aj-floater/hexapod/media/callibration_rig1_5.jpeg

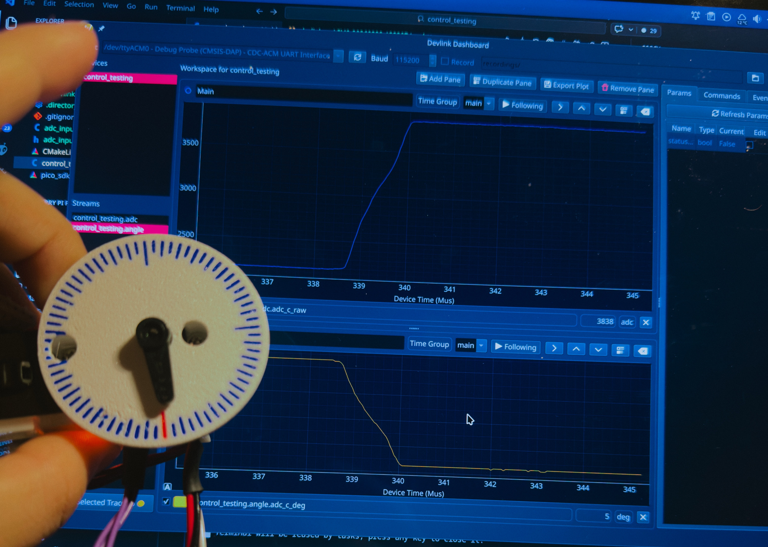
media/callibration_rig1_5.jpeg
