aj-floater/hexapod/media/callibration_rig1_86.jpeg

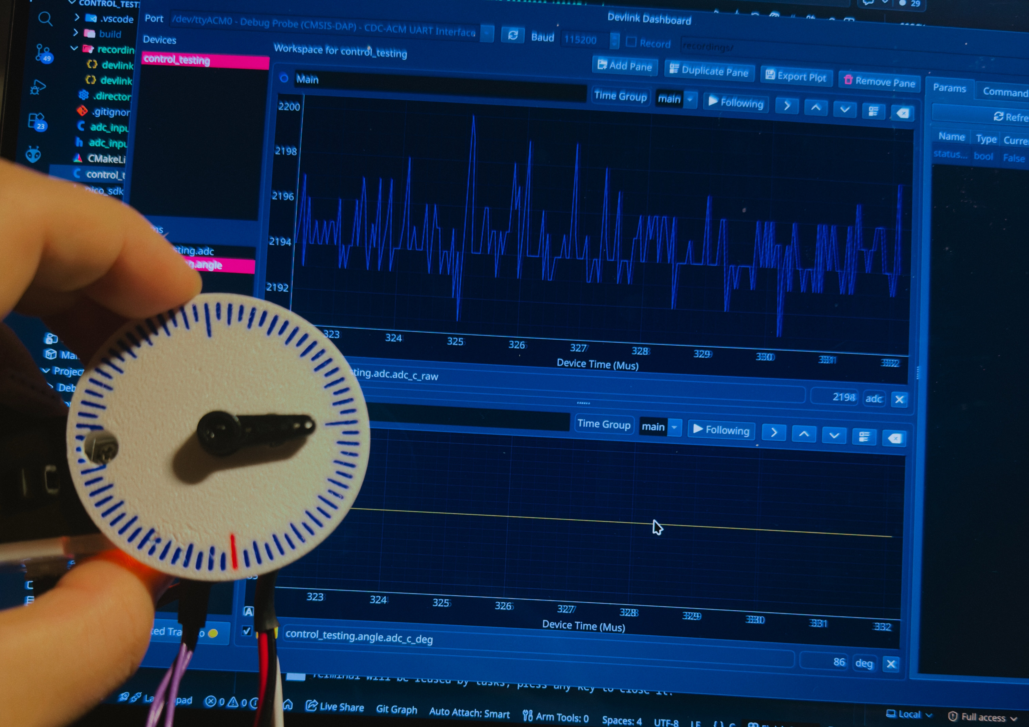
media/callibration_rig1_86.jpeg
