aj-floater/hexapod/hardware/smart_servo_v2/smart_servo_v2_log_missing3Dmodels.txt

[('Y1', '/Users/archiejames/coding/hexapod/hardware/smart_servo_v2/ABM8-272-T3.stp'), ('L1', '/Applications/KiCad/KiCad.app/Contents/SharedSupport/3dmodels/Inductor_SMD.3dshapes/L_Bourns_SRP7028A_7.3x6.6mm.step'), ('IC2', '/Users/archiejames/coding/hexapod/hardware/smart_servo_v2/MP2315GJ-P.stp'), ('IC1', '/Users/archiejames/coding/hexapod/hardware/smart_servo_v2/AP7370-33SA-7.stp')]
