aj-floater/hexapod/firmware/basic_control_testing/speed2_designed_servo_tracking_relative.png

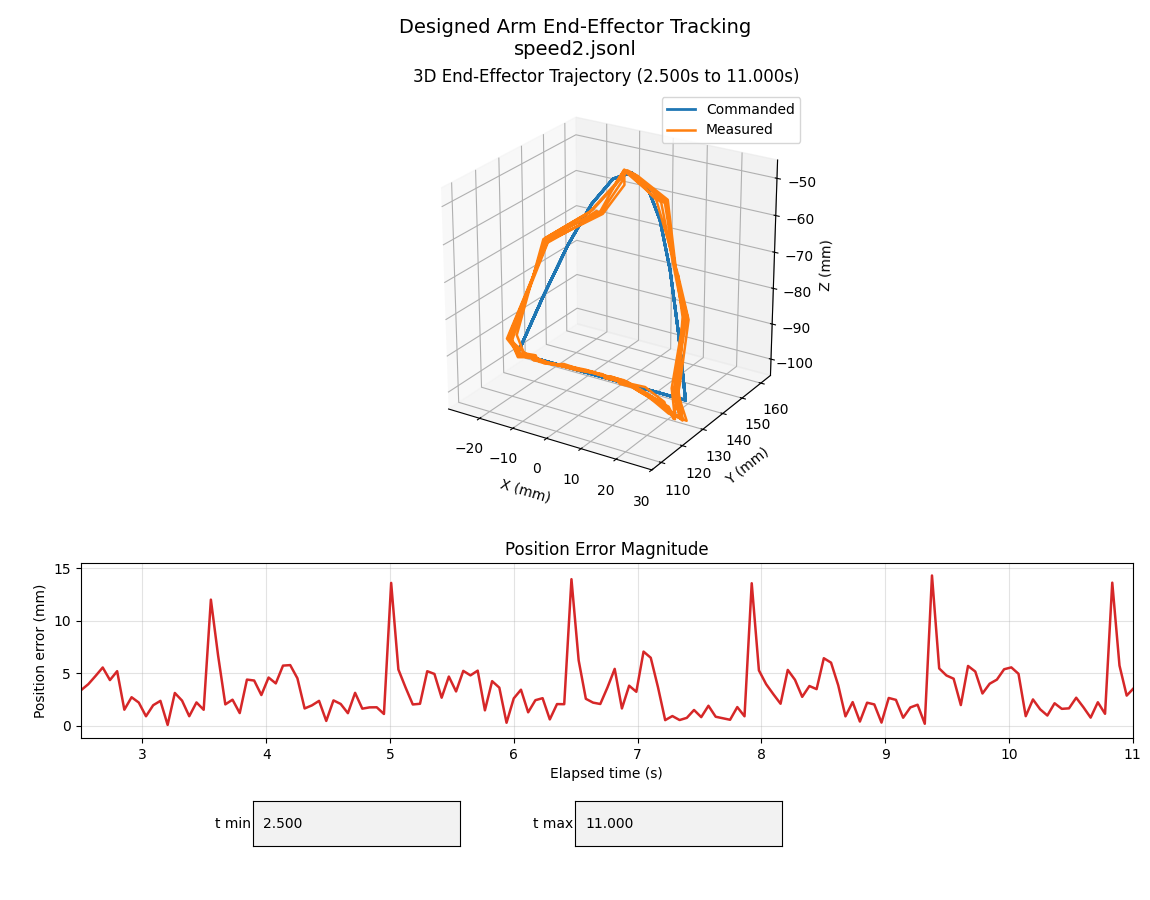
firmware/basic_control_testing/speed2_designed_servo_tracking_relative.png
