aj-floater/hexapod/media/Average & Low Pass Filtering.png

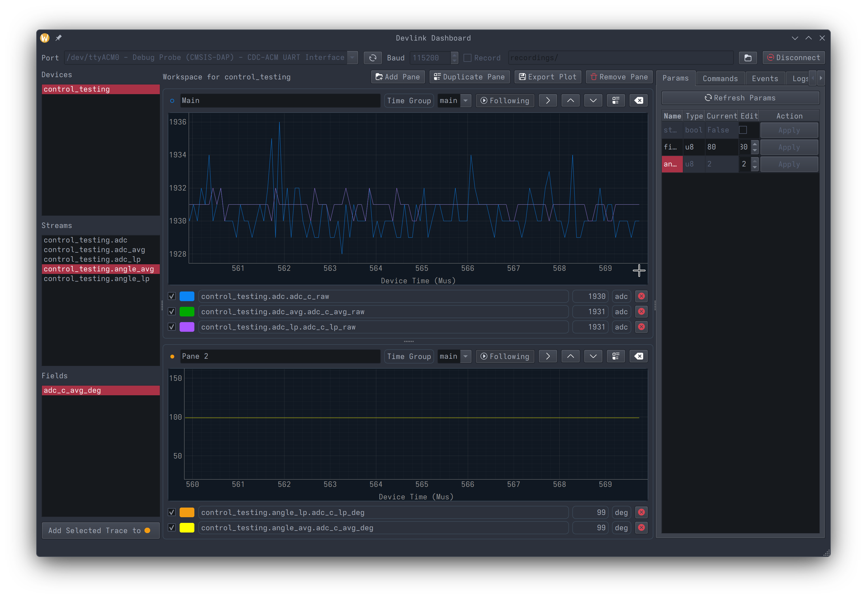
media/Average & Low Pass Filtering.png
