aj-floater/hexapod/media/bouncing.png

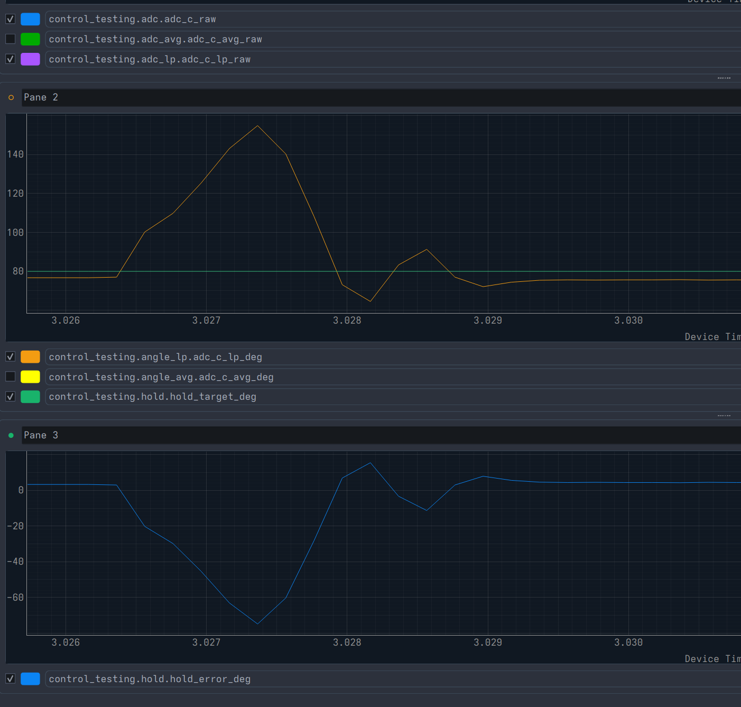
media/bouncing.png
