aj-floater/hexapod/media/callibration_rig1_87.jpeg

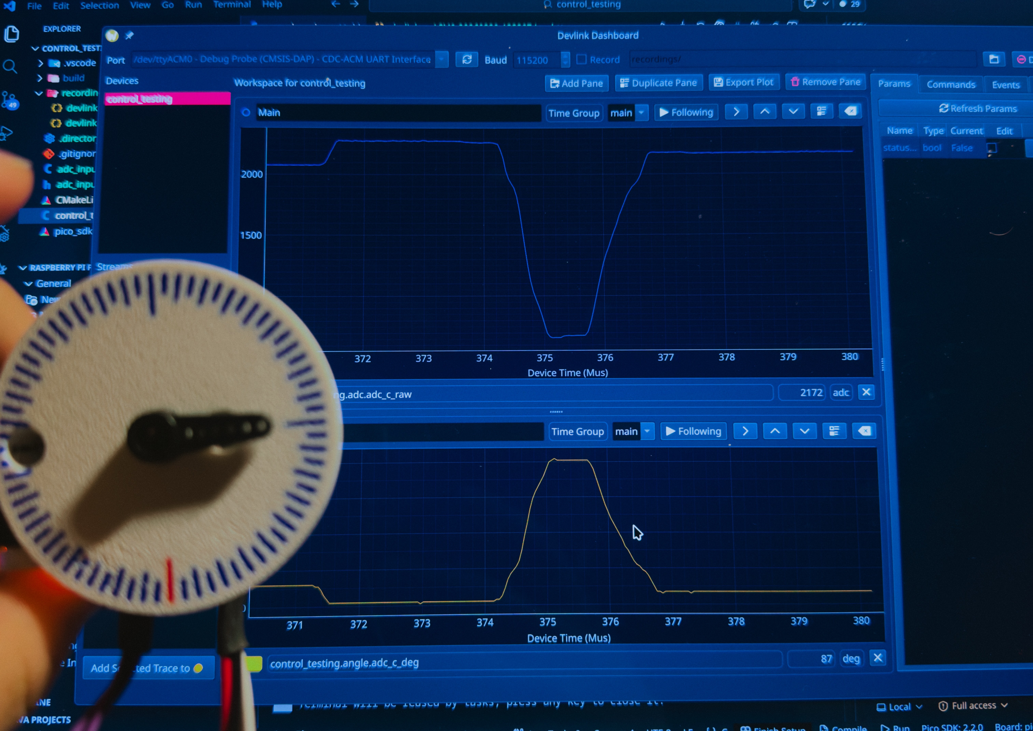
media/callibration_rig1_87.jpeg
