aj-floater/hexapod/media/callibration_rig1_180.jpeg

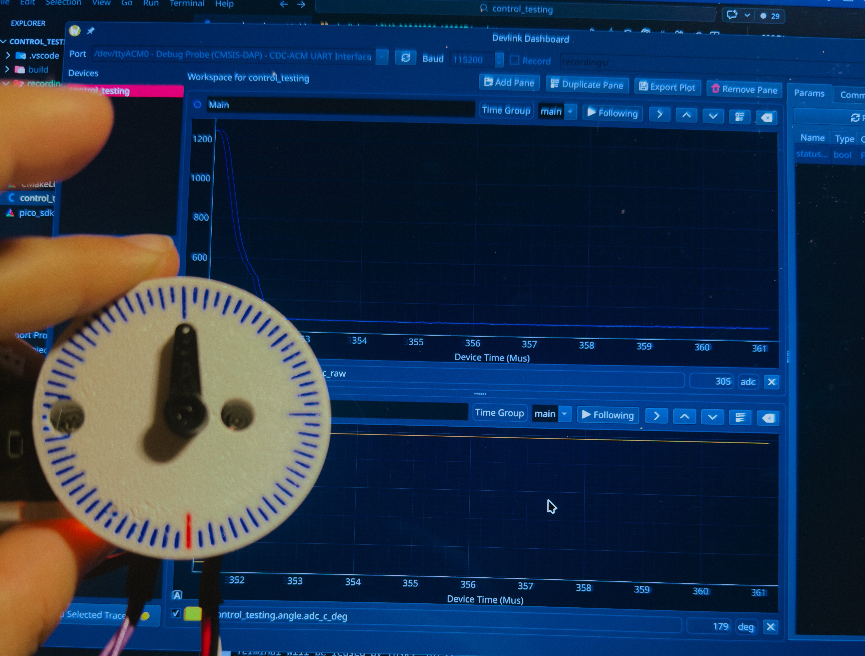
media/callibration_rig1_180.jpeg
