aj-floater/hexapod/media/callibration_rig.png

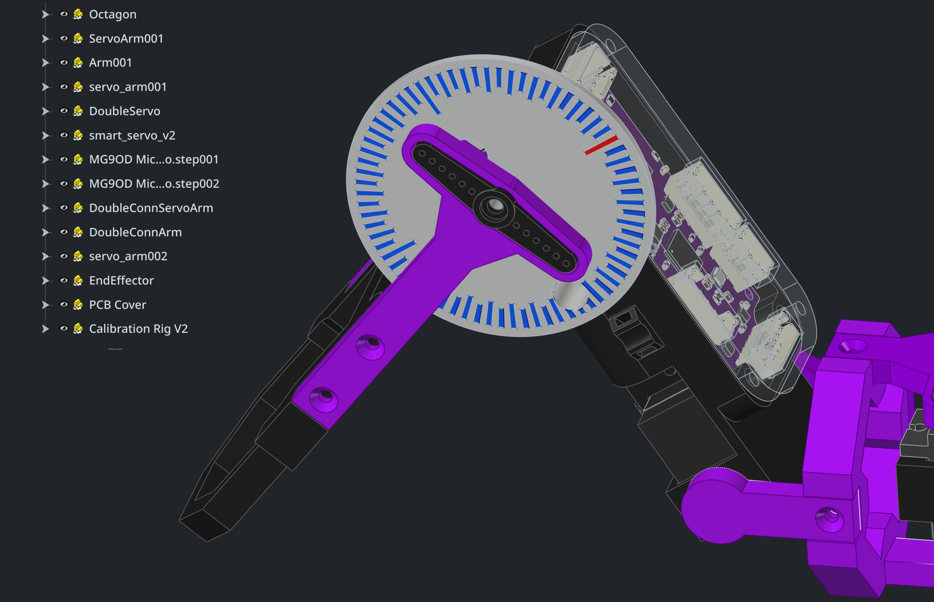
media/callibration_rig.png
