aj-floater/hexapod/media/first_callibration_rig.png

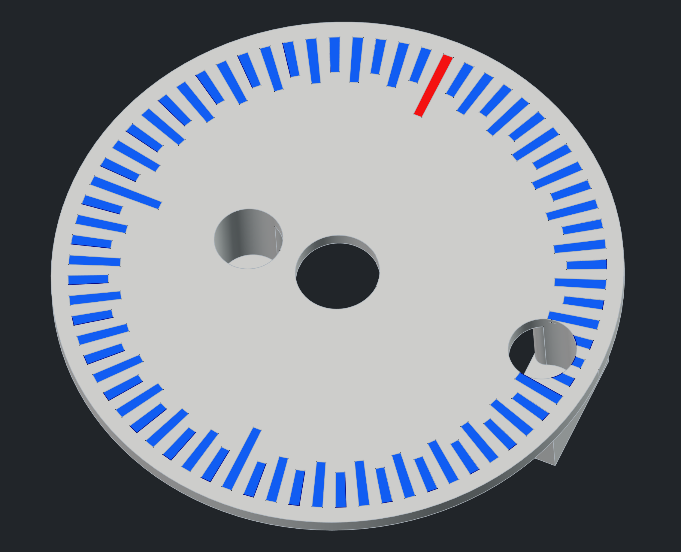
media/first_callibration_rig.png
