aj-floater/hexapod/media/NewCallibrationRig.png

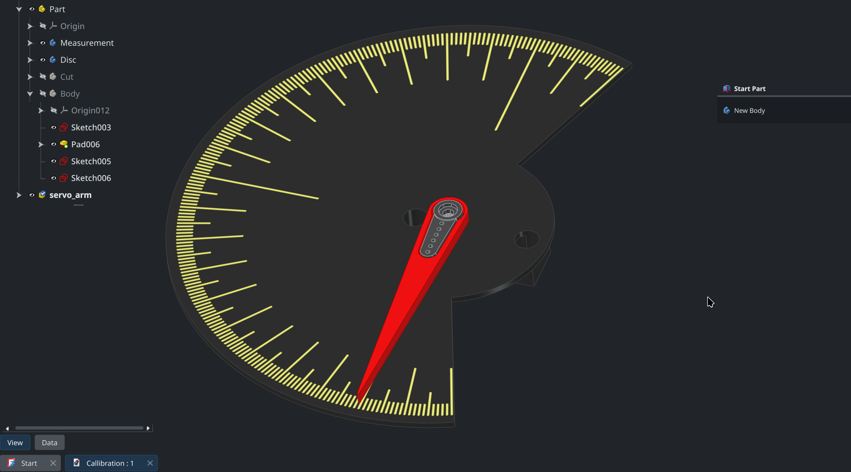
media/NewCallibrationRig.png
