aj-floater/hexapod/media/proportional_control.png

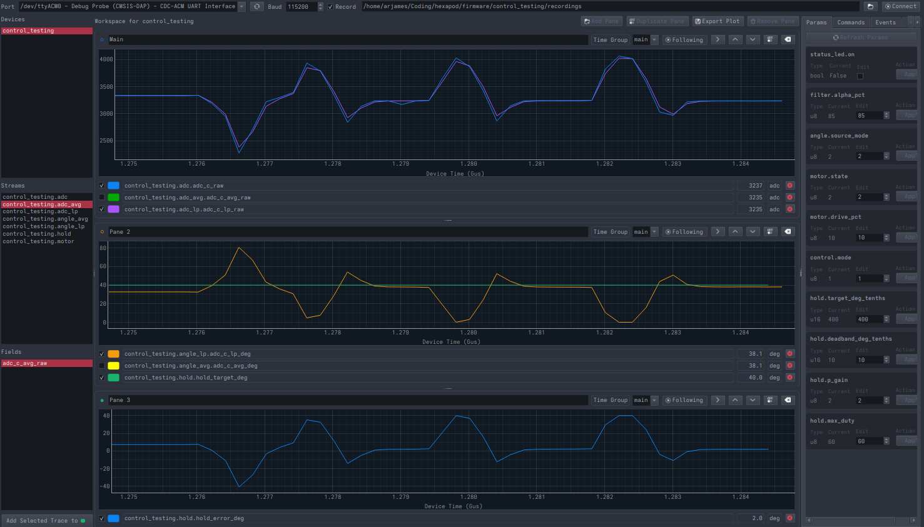
media/proportional_control.png
