aj-floater/hexapod/hardware/smart_servo/bom.xlsx

Quantity | Cost Per | Cost Total | Matched Part Number | Description | Selected Distributor | SKU | Distributor Link | Checked | Ordered
1 | £0.55 | £0.55 | MCP1703T-3302E/CB | Fixed LDO Voltage Regulator, 2.7V to 16V, 525mV Dropout, 3.3Vout, 250mAout, SOT-23A-3 | Farnell | 1439518 | https://uk.farnell.com/microchip/mcp1703t-3302e-cb/v-reg-ldo-250ma-3-3v-sot-23a-3/dp/1439518 | ✓
1 | £0.25 | £0.25 | TL431IDBZR,215 | Voltage Reference, Precision, Shunt - Adjustable, AEC-Q100 TL431 Series, 2.495V to 36V, SOT-23-3 | Farnell | 2095480 | https://uk.farnell.com/nexperia/tl431idbzr-215/voltage-ref-shunt-2-495v-36v-sot/dp/2095480 | ✓
1 | £2.21 | £2.21 | STM32F042F6P6 | ARM MCU, USB Line, STM32 Family STM32F0 Series Microcontrollers, ARM Cortex-M0, 32 bit, 48 MHz | Farnell | 2469549 | https://uk.farnell.com/stmicroelectronics/stm32f042f6p6/mcu-32bit-cortex-m0-48mhz-tssop/dp/2469549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 | ✓
1 | £0.92 | £0.92 | DRV8837DSGR | Motor Driver, Low Voltage H Bridge, 2 Outputs, 1.8 V to 7 V Supply, 0 V to 11 V/1.8 A Out, WSON-8 | Farnell | 3005855 | https://uk.farnell.com/texas-instruments/drv8837dsgr/motor-driver-dc-brushed-1-8a-wson/dp/3005855 | ✓
1 | £0.73 | £0.73 | 217179-0001 | USB Connector, USB Type C, USB 2.0, Receptacle, 16 Ways, Surface Mount, Through Hole Mount | Farnell | 3702965 | https://uk.farnell.com/molex/217179-0001/usb-conn-2-0-type-c-rcpt-16pos/dp/3702965?CMP=GRHB-OCTOPART | ✓
1 | £0.11 | £0.11 | B5B-PH-K-S(LF)(SN) | Pin Header, Wire-to-Board, 2 mm, 1 Rows, 5 Contacts, Through Hole Straight, PH | Farnell | 9492445 | https://uk.farnell.com/jst-japan-solderless-terminals/b5b-ph-k-s-lf-sn/connector-header-tht-2mm-5way/dp/9492445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 | ✓
1 | £0.04 | £0.04 | PHR-5 | Connector Housing, PH, Receptacle, 5 Ways, 2 mm, BPH and SPH Series Crimp Contacts | Farnell | 3616216 | https://uk.farnell.com/jst-japan-solderless-terminals/phr-5/housing-wire-board-5way-2mm/dp/3616216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 | ✓
1 | £0.07 | £0.07 | B3B-PH-K-S(LF)(SN) | Pin Header, Wire-to-Board, 2 mm, 1 Rows, 3 Contacts, Through Hole Straight, PH | Farnell | 9492429 | https://uk.farnell.com/jst-japan-solderless-terminals/b3b-ph-k-s-lf-sn/header-top-entry-3way/dp/9492429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 | ✓
1 | £0.03 | £0.03 | PHR-3 | Connector Housing, PH, Receptacle, 3 Ways, 2 mm, BPH and SPH Series Crimp Contacts | Farnell | 3616198 | https://uk.farnell.com/jst-japan-solderless-terminals/phr-3/housing-3way-2mm/dp/3616198 | ✓
2 | £0.04 | £0.08 | 0805F106Z100CT | SMD Multilayer Ceramic Capacitor, 10 µF, 10 V, 0805 [2012 Metric], -20%, +80%, Y5V | Farnell | 2495498 | https://uk.farnell.com/multicomp-pro/0805f106z100ct/cap-10-f-10v-y5v-0805-reel/dp/2495498 | ✓
3 | £0.01 | £0.02 | 0402B104K160CT | SMD Multilayer Ceramic Capacitor, 0.1 µF, 16 V, 0402 [1005 Metric], ± 10%, X7R | Farnell | 2495270 | https://uk.farnell.com/multicomp-pro/0402b104k160ct/cap-0-1-f-16v-10-x7r-0402-reel/dp/2495270 | ✓
2 | £0.01 | £0.02 | CRCW06035K10FKEA | SMD Chip Resistor, 5.1 kohm, ± 1%, 125 mW, 0603 [1608 Metric], Thick Film, General Purpose | Farnell | 2122454 | https://uk.farnell.com/vishay/crcw06035k10fkea/res-5k1-1-0-1w-0603-thick-film/dp/2122454 | ✓
1 | £0.0019 | £0.0019 | CRG0402F120R | SMD Chip Resistor, 120 ohm, ± 1%, 62.5 mW, 0402 [1005 Metric], Thick Film, General Purpose | Farnell | 2692935 | https://uk.farnell.com/te-connectivity/crg0402f120r/res-120r-1-0-063w-0402-thick-film/dp/2692935 | ✓
1 | £0.0028 | £0.0028 | CRCW040210K0FKED | SMD Chip Resistor, 10 kohm, ± 1%, 100 mW, 0402 [1005 Metric], Thick Film, General Purpose | Farnell | 2121730 | https://uk.farnell.com/vishay/crcw040210k0fked/res-10k-1-0-063w-0402-thick-film/dp/2121730 | ✓
 | Total Cost | £5.05
