aj-floater/hexapod/hardware/CAD/Parts.FCStd

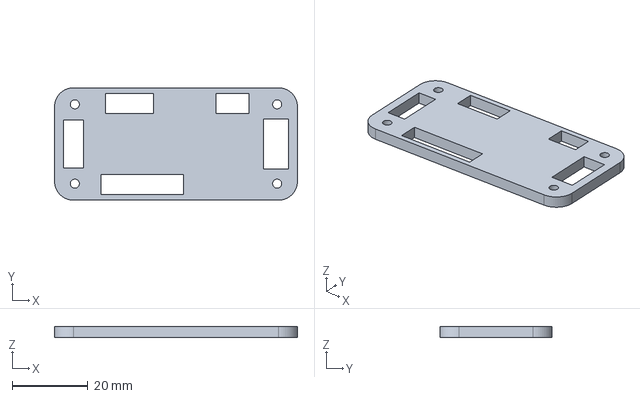
[picture p16: CAD file, 2026-05-02]
hardware/CAD/Parts.FCStd
64.0 x 29.6 x 3.00 mm
