aj-floater/hexapod/hardware/smart_servo/smart_servo.step

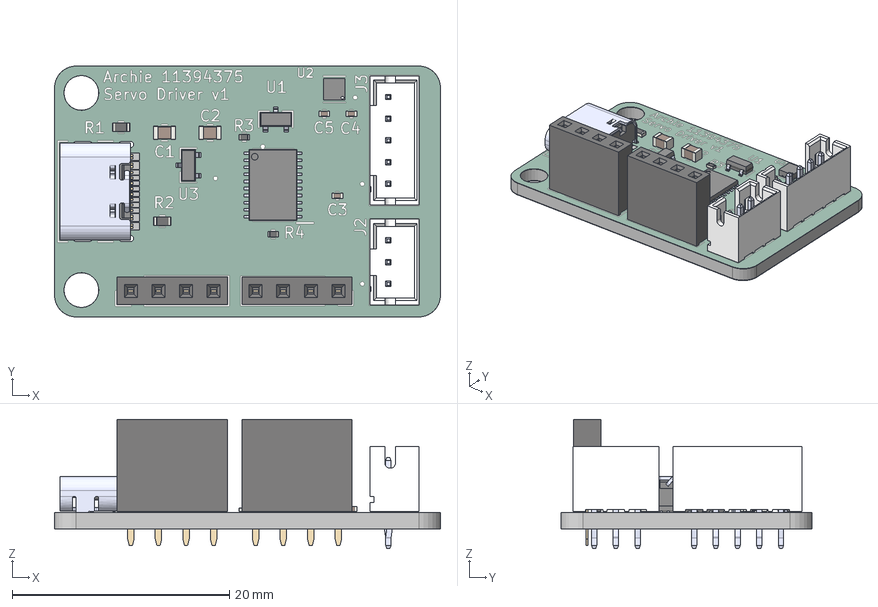
[picture p17: CAD file, 2026-02-13]
hardware/smart_servo/smart_servo.step
35.5 x 23.1 x 11.9 mm
C_0805_2012Metric x 2
pin x 5
R_0603_1608Metric x 2
R_0402_1005Metric x 2
C_0402_1005Metric x 3
TL431IDBZR_215 x 2
PinSocket_1x04_P2.54mm_Vertical x 2
B3B-PH-K-S_LF__SN_
STM32F042F6P6
DRV8837DSGR
smart_servo_silkscreen
smart_servo_soldermask x 2
smart_servo_PCB
