aj-floater/hexapod/software/bleep/bleep/models/3mf/thirdJoint.3mf

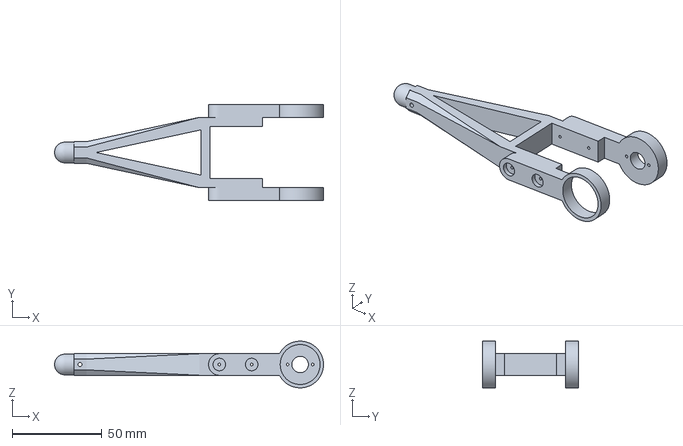
[picture p18: CAD file, 2026-05-02]
software/bleep/bleep/models/3mf/thirdJoint.3mf
149.7 x 53.2 x 26.0 mm
