aj-floater/hexapod/software/bleep/bleep/models/basics/cow.obj

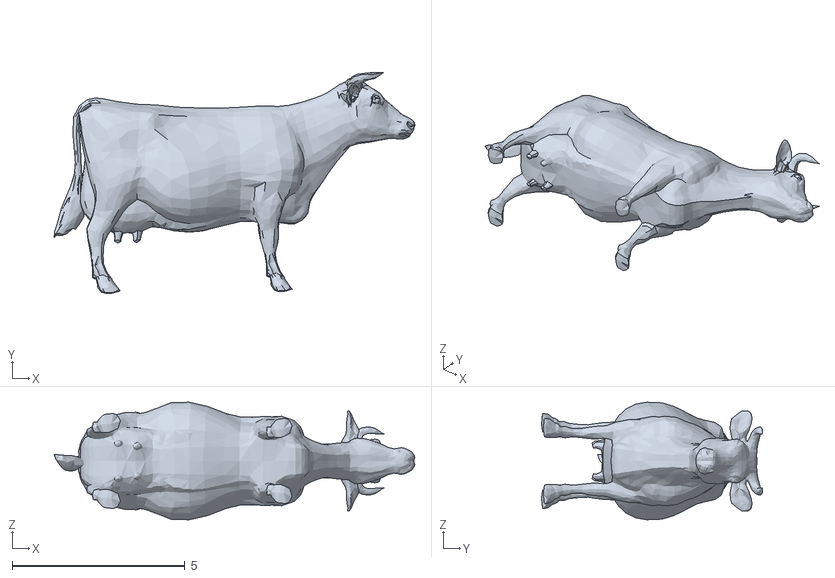
[picture p19: CAD file, 2026-05-02]
software/bleep/bleep/models/basics/cow.obj
10.4 x 6.40 x 3.40
