aj-floater/hexapod/software/bleep/bleep/models/body.stl

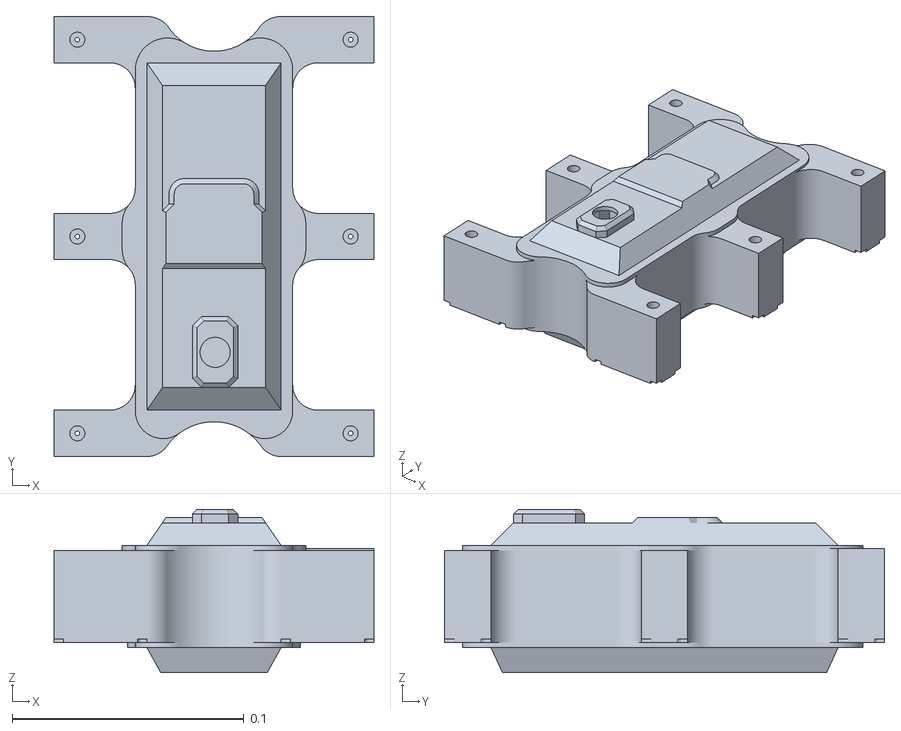
[picture p20: CAD file, 2026-05-02]
software/bleep/bleep/models/body.stl
0.138 x 0.19 x 0.0704
