aj-floater/hexapod/software/bleep/bleep/models/3mf/baseJoint.3mf

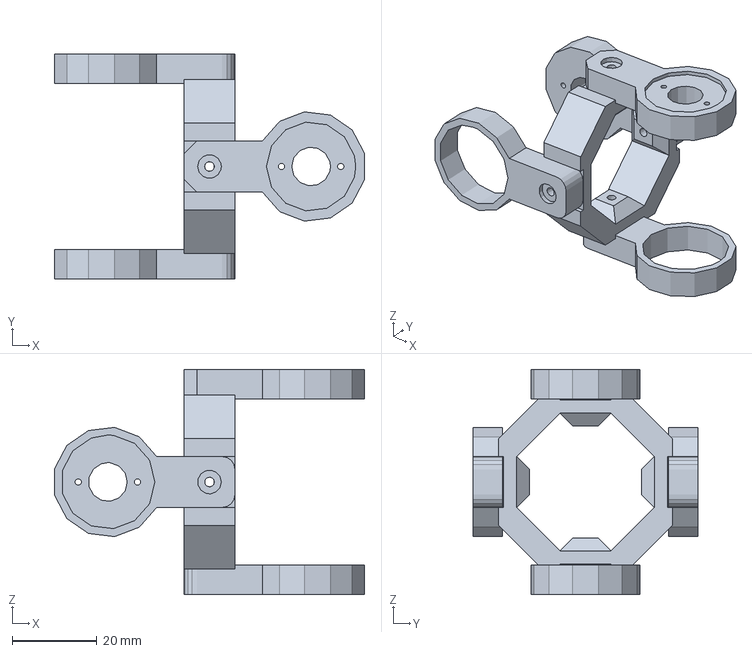
[picture p21: CAD file, 2026-05-02]
software/bleep/bleep/models/3mf/baseJoint.3mf
73.2 x 53.2 x 53.2 mm
