aj-floater/hexapod/software/bleep/bleep/models/basics/cylinder.obj

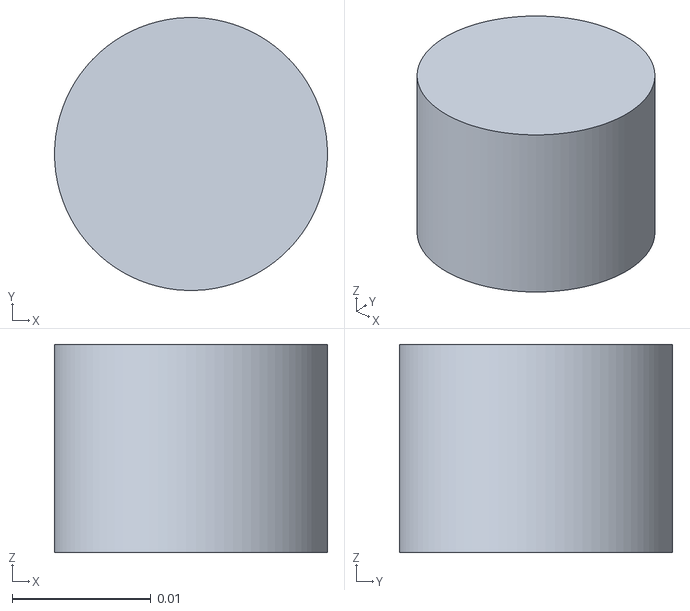
[picture p22: CAD file, 2026-05-02]
software/bleep/bleep/models/basics/cylinder.obj
0.0197 x 0.0196 x 0.015
