aj-floater/hexapod/hardware/CAD/Callibration.FCStd

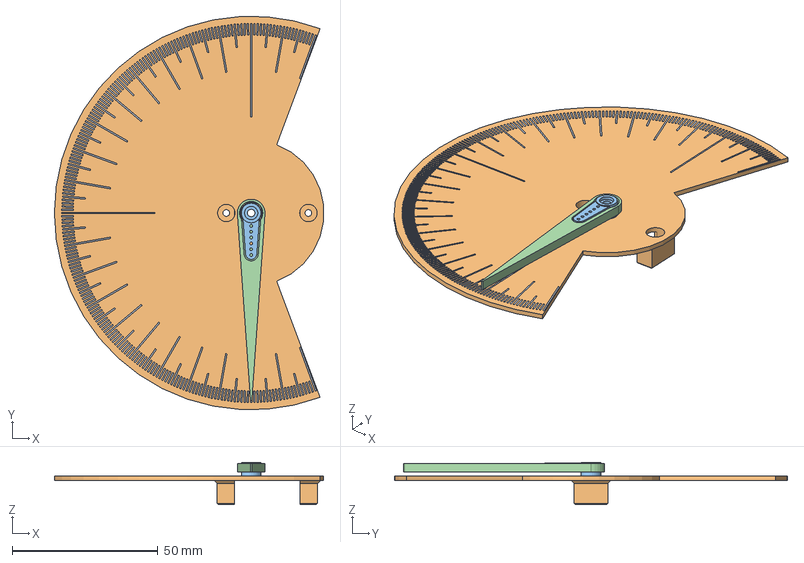
[picture p23: CAD file, 2026-03-30]
hardware/CAD/Callibration.FCStd
92.3 x 134.8 x 14.6 mm
Measurement
Disc
Arm
ArmAddon
