aj-floater/hexapod/software/bleep/bleep/models/3mf/secondJoint.3mf

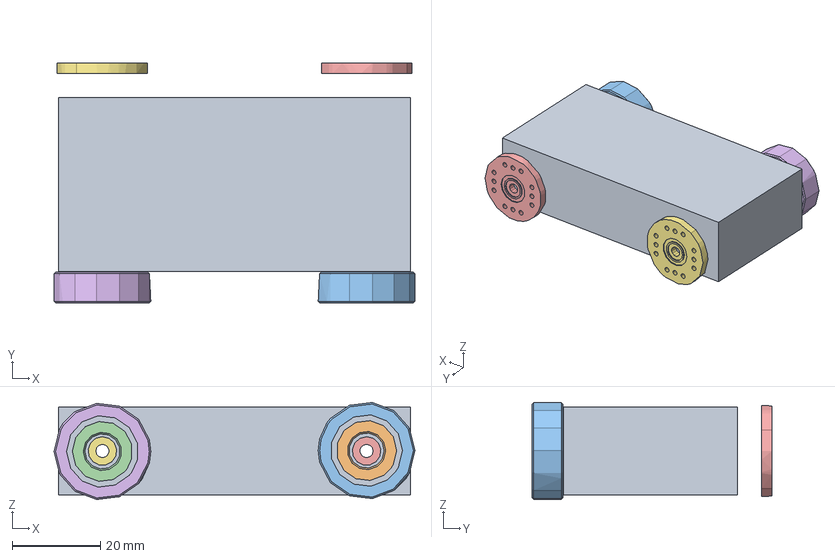
[picture p24: CAD file, 2026-05-02]
software/bleep/bleep/models/3mf/secondJoint.3mf
82.0 x 54.5 x 22.0 mm
Imported_50_(8)
Imported_51_(8)
Imported_50_(9)
Imported_54_(8)
Imported_51_(9)
Imported_54_(9)
