aj-floater/hexapod/software/bleep/bleep/models/basics/scene.obj

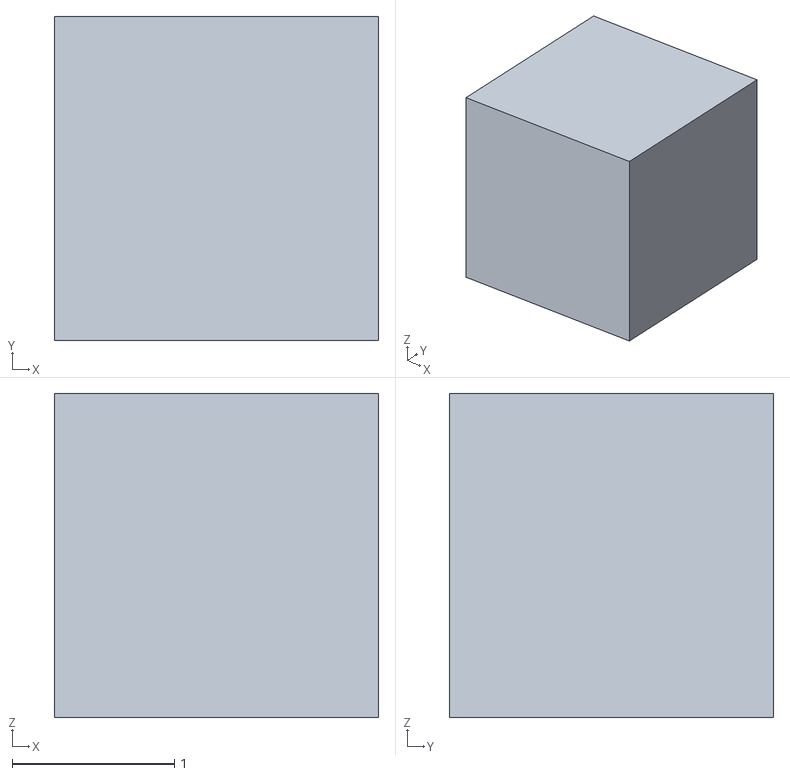
[picture p25: CAD file, 2026-05-02]
software/bleep/bleep/models/basics/scene.obj
2.00 x 2.00 x 2.00
