aj-floater/hexapod/hardware/smart_servo_v2/smart_servo_v2.step

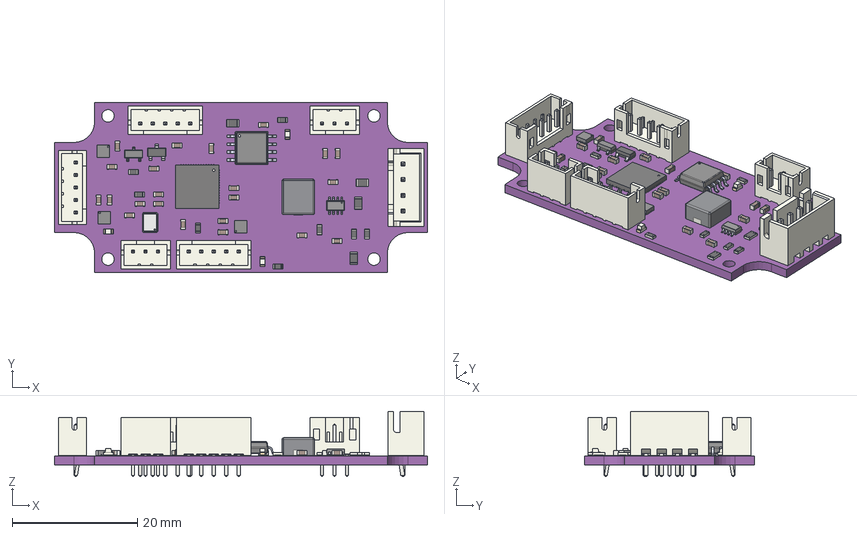
[picture p26: CAD file, 2026-02-13, an earlier design]
hardware/smart_servo_v2/smart_servo_v2.step
59.6 x 27.2 x 10.4 mm
C_0603_1608Metric x 22
W25Q32JVSSIQ
QFN-56-1EP_7x7mm_P0.4mm_EP3.2x3.2mm
LED_0603_1608Metric x 3
R_0603_1608Metric x 8
R_0805_2012Metric x 4
JST_PH_B3B-PH-K_1x03_P2.00mm_Vertical x 2
JST_PH_B5B-PH-K_1x05_P2.00mm_Vertical x 3
PinsArrayLR
L_Bourns_SRP5030T
DRV8837DSGR x 3
ABM8-272-T3
JST_XH_B4B-XH-A_1x04_P2.50mm_Vertical
TL431IDBZR_215
AP7370-33SA-7
smart_servo_v2_PCB
