aj-floater/hexapod/(list of files, cad)

Other CAD files:
hardware/CAD/LegAssembly.FCStd
software/bleep/bleep/models/baseJoint.obj
software/bleep/bleep/models/baseJoint.stl
software/bleep/bleep/models/secondJoint.obj
software/bleep/bleep/models/secondJoint.stl
software/bleep/bleep/models/thirdJoint.obj
software/bleep/bleep/models/thirdJoint.stl
