aj-floater/hexapod/firmware/basic_control_testing/basic_leg_assembly_pose_side_on.png

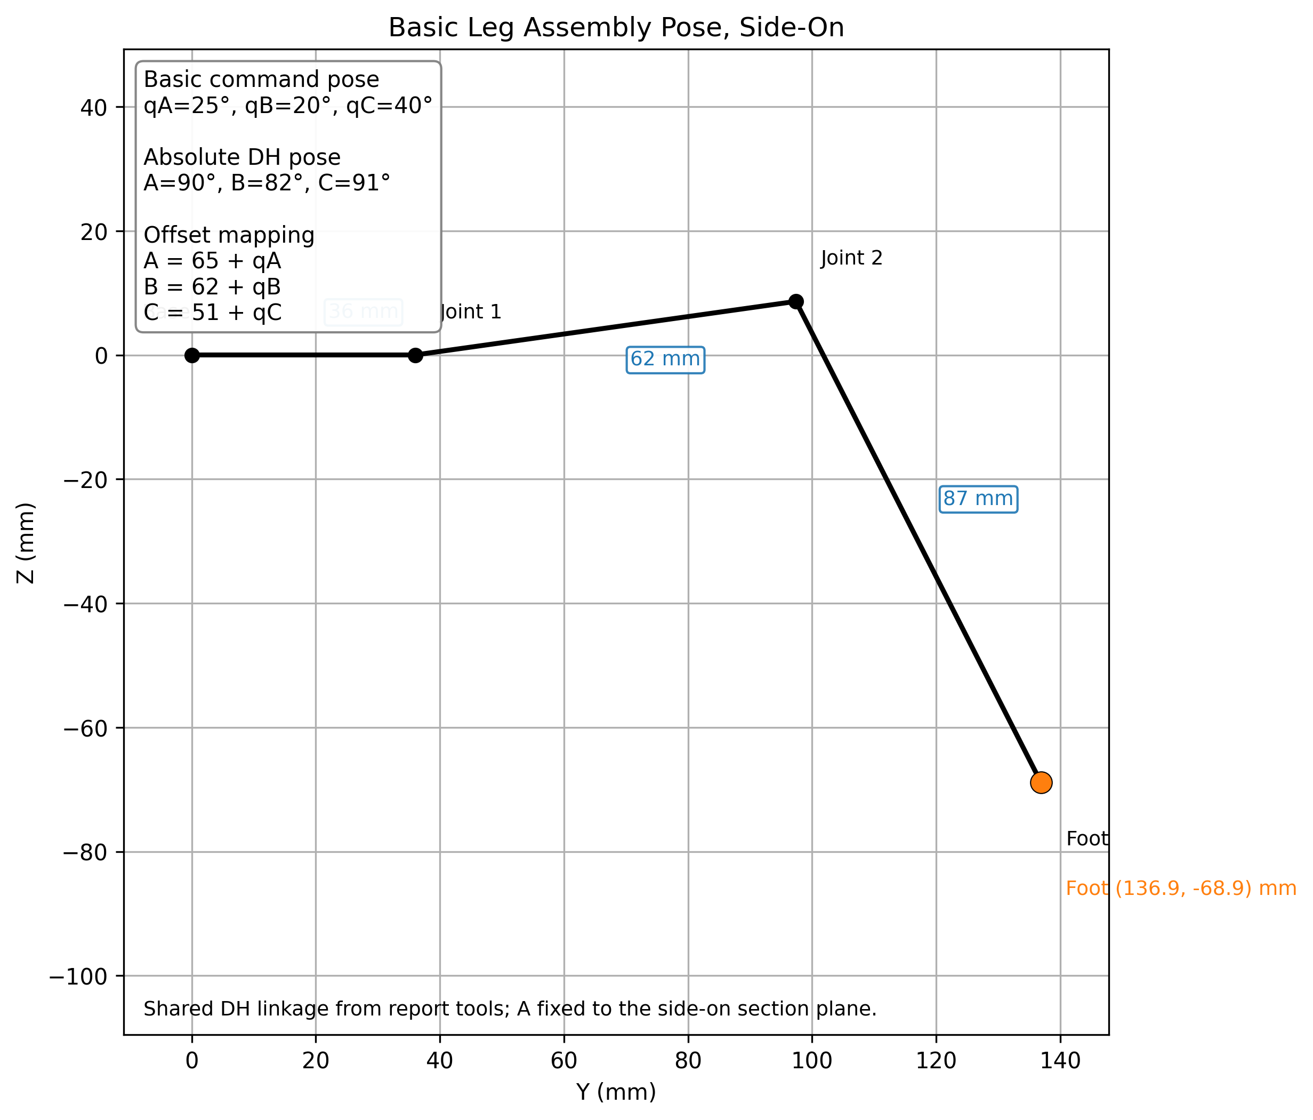
firmware/basic_control_testing/basic_leg_assembly_pose_side_on.png
