aj-floater/hexapod/media/assembly.png

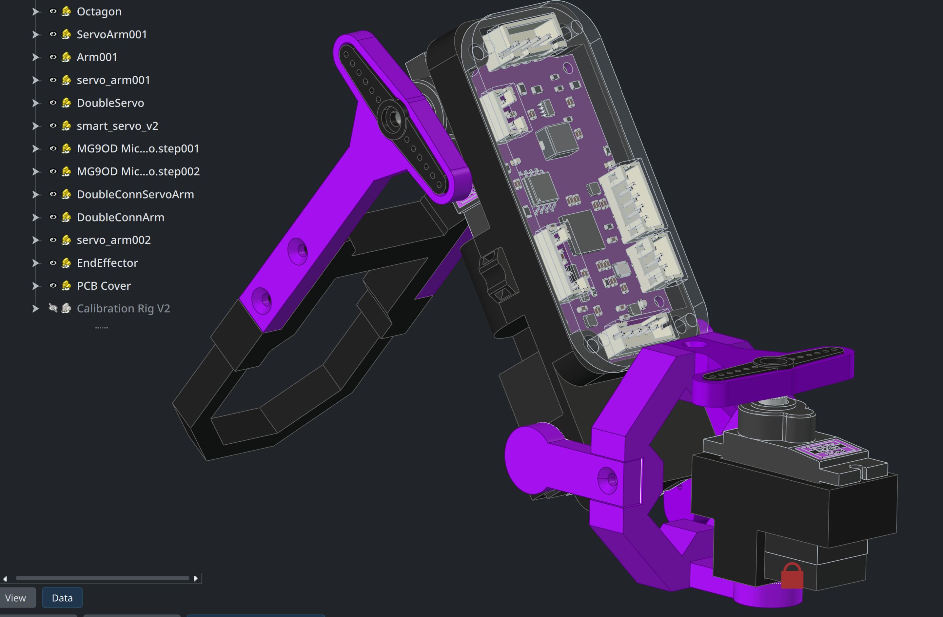
media/assembly.png
