aj-floater/hexapod/firmware/basic_control_testing/speed0.csv

state | speed_mode | cycle_time_ms | time_us | sample_index | phase_u | cmd_x_mm | cmd_y_mm | cmd_z_mm | cmd_q_a_deg | cmd_q_b_deg | cmd_q_c_deg | cmd_a_abs_deg | cmd_b_abs_deg | cmd_c_abs_deg | adc_a_raw | adc_b_raw | adc_c_raw | meas_q_a_deg | meas_q_b_deg | meas_q_c_deg | meas_a_abs_deg | meas_b_abs_deg | meas_c_abs_deg | meas_x_mm | meas_y_mm | meas_z_mm
running | 0 | 2000 | 2307581895 | 0 | 0.000 | 25.00 | 130.00 | -98.00 | 14 | 46 | 15 | 79.00 | 108.00 | 66.00 | 2288 | 1702 | 2261 | 16.07 | 44.07 | 17.79 | 81.07 | 106.07 | 68.79 | 20.58 | 130.93 | -95.92
running | 0 | 2000 | 2307602223 | 1 | 0.010 | 24.17 | 130.00 | -98.00 | 14 | 46 | 15 | 79.00 | 108.00 | 66.00 | 2291 | 1703 | 2265 | 15.92 | 44.02 | 17.60 | 80.92 | 106.02 | 68.60 | 20.97 | 131.22 | -95.71
running | 0 | 2000 | 2307622401 | 2 | 0.020 | 23.33 | 130.00 | -98.00 | 15 | 46 | 16 | 80.00 | 108.00 | 67.00 | 2290 | 1692 | 2273 | 15.97 | 44.56 | 17.21 | 80.97 | 106.56 | 68.21 | 20.80 | 130.88 | -96.37
running | 0 | 2000 | 2307642539 | 3 | 0.030 | 22.50 | 130.00 | -98.00 | 15 | 46 | 16 | 80.00 | 108.00 | 67.00 | 2290 | 1684 | 2274 | 15.97 | 44.95 | 17.16 | 80.97 | 106.95 | 68.16 | 20.70 | 130.29 | -96.99
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
