aj-floater/hexapod/firmware/basic_control_testing/speed1.csv

state | speed_mode | cycle_time_ms | time_us | sample_index | phase_u | cmd_x_mm | cmd_y_mm | cmd_z_mm | cmd_q_a_deg | cmd_q_b_deg | cmd_q_c_deg | cmd_a_abs_deg | cmd_b_abs_deg | cmd_c_abs_deg | adc_a_raw | adc_b_raw | adc_c_raw | meas_q_a_deg | meas_q_b_deg | meas_q_c_deg | meas_a_abs_deg | meas_b_abs_deg | meas_c_abs_deg | meas_x_mm | meas_y_mm | meas_z_mm
running | 1 | 1500 | 2907942167 | 0 | 0.000 | 25.00 | 130.00 | -98.00 | 14 | 46 | 15 | 79.00 | 108.00 | 66.00 | 2278 | 1711 | 2262 | 16.55 | 43.63 | 17.75 | 81.55 | 105.63 | 68.75 | 19.59 | 131.89 | -95.14
running | 1 | 1500 | 2907962371 | 1 | 0.013 | 23.89 | 130.00 | -98.00 | 15 | 46 | 15 | 80.00 | 108.00 | 66.00 | 2294 | 1690 | 2267 | 15.78 | 44.66 | 17.50 | 80.78 | 106.66 | 68.50 | 21.15 | 130.24 | -96.72
running | 1 | 1500 | 2907982533 | 2 | 0.027 | 22.78 | 130.00 | -98.00 | 15 | 46 | 16 | 80.00 | 108.00 | 67.00 | 2306 | 1693 | 2270 | 15.19 | 44.51 | 17.35 | 80.19 | 106.51 | 68.35 | 22.55 | 130.47 | -96.38
running | 1 | 1500 | 2908002675 | 4 | 0.040 | 21.67 | 130.00 | -98.00 | 16 | 46 | 16 | 81.00 | 108.00 | 67.00 | 2290 | 1689 | 2274 | 15.97 | 44.71 | 17.16 | 80.97 | 106.71 | 68.16 | 20.77 | 130.70 | -96.58
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
