aj-floater/hexapod/firmware/basic_control_testing/speed2.csv

state | speed_mode | cycle_time_ms | time_us | sample_index | phase_u | cmd_x_mm | cmd_y_mm | cmd_z_mm | cmd_q_a_deg | cmd_q_b_deg | cmd_q_c_deg | cmd_a_abs_deg | cmd_b_abs_deg | cmd_c_abs_deg | adc_a_raw | adc_b_raw | adc_c_raw | meas_q_a_deg | meas_q_b_deg | meas_q_c_deg | meas_a_abs_deg | meas_b_abs_deg | meas_c_abs_deg | meas_x_mm | meas_y_mm | meas_z_mm
running | 2 | 1000 | 2947961867 | 0 | 0.000 | 25.00 | 130.00 | -98.00 | 14 | 46 | 15 | 79.00 | 108.00 | 66.00 | 2280 | 1700 | 2262 | 16.46 | 44.17 | 17.75 | 81.46 | 106.17 | 68.75 | 19.68 | 130.97 | -96.05
running | 2 | 1000 | 2947982097 | 2 | 0.020 | 23.33 | 130.00 | -98.00 | 15 | 46 | 16 | 80.00 | 108.00 | 67.00 | 2297 | 1702 | 2266 | 15.63 | 44.07 | 17.55 | 80.63 | 106.07 | 68.55 | 21.63 | 131.10 | -95.76
running | 2 | 1000 | 2948002262 | 4 | 0.040 | 21.67 | 130.00 | -98.00 | 16 | 46 | 16 | 81.00 | 108.00 | 67.00 | 2305 | 1689 | 2271 | 15.24 | 44.71 | 17.30 | 80.24 | 106.71 | 68.30 | 22.39 | 130.23 | -96.68
running | 2 | 1000 | 2948022411 | 6 | 0.060 | 20.00 | 130.00 | -98.00 | 16 | 46 | 16 | 81.00 | 108.00 | 67.00 | 2293 | 1673 | 2269 | 15.83 | 45.49 | 17.40 | 80.83 | 107.49 | 68.40 | 20.83 | 129.00 | -98.05
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
