aj-floater/hexapod/firmware/basic_control_testing/speed3.csv

state | speed_mode | cycle_time_ms | time_us | sample_index | phase_u | cmd_x_mm | cmd_y_mm | cmd_z_mm | cmd_q_a_deg | cmd_q_b_deg | cmd_q_c_deg | cmd_a_abs_deg | cmd_b_abs_deg | cmd_c_abs_deg | adc_a_raw | adc_b_raw | adc_c_raw | meas_q_a_deg | meas_q_b_deg | meas_q_c_deg | meas_a_abs_deg | meas_b_abs_deg | meas_c_abs_deg | meas_x_mm | meas_y_mm | meas_z_mm
running | 3 | 750 | 2988202270 | 0 | 0.000 | 25.00 | 130.00 | -98.00 | 14 | 46 | 15 | 79.00 | 108.00 | 66.00 | 2279 | 1710 | 2262 | 16.50 | 43.68 | 17.75 | 81.50 | 105.68 | 68.75 | 19.69 | 131.79 | -95.23
running | 3 | 750 | 2988222482 | 2 | 0.027 | 22.78 | 130.00 | -98.00 | 15 | 46 | 16 | 80.00 | 108.00 | 67.00 | 2294 | 1688 | 2270 | 15.78 | 44.75 | 17.35 | 80.78 | 106.75 | 68.35 | 21.16 | 130.28 | -96.79
running | 3 | 750 | 2988242648 | 5 | 0.053 | 20.56 | 130.00 | -98.00 | 16 | 46 | 16 | 81.00 | 108.00 | 67.00 | 2306 | 1700 | 2273 | 15.19 | 44.17 | 17.21 | 80.19 | 106.17 | 68.21 | 22.68 | 131.23 | -95.70
running | 3 | 750 | 2988261805 | 8 | 0.080 | 18.33 | 130.00 | -98.00 | 17 | 46 | 17 | 82.00 | 108.00 | 68.00 | 2293 | 1688 | 2274 | 15.83 | 44.75 | 17.16 | 80.83 | 106.75 | 68.16 | 21.09 | 130.57 | -96.67
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
