aj-floater/hexapod/firmware/basic_control_testing/speed0_servo_tracking_relative.png

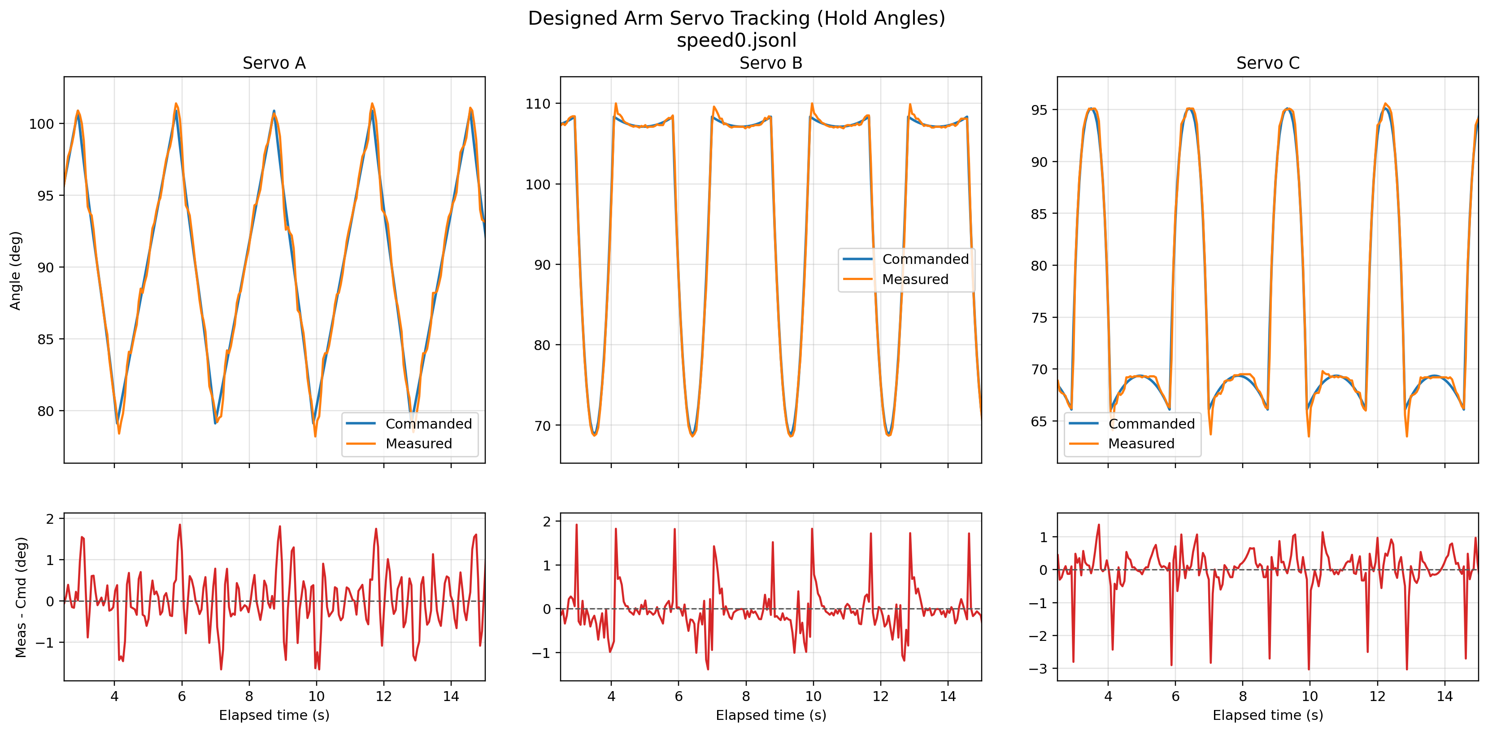
firmware/basic_control_testing/speed0_servo_tracking_relative.png
