aj-floater/hexapod/firmware/basic_control_testing/speed1_servo_tracking_relative.png

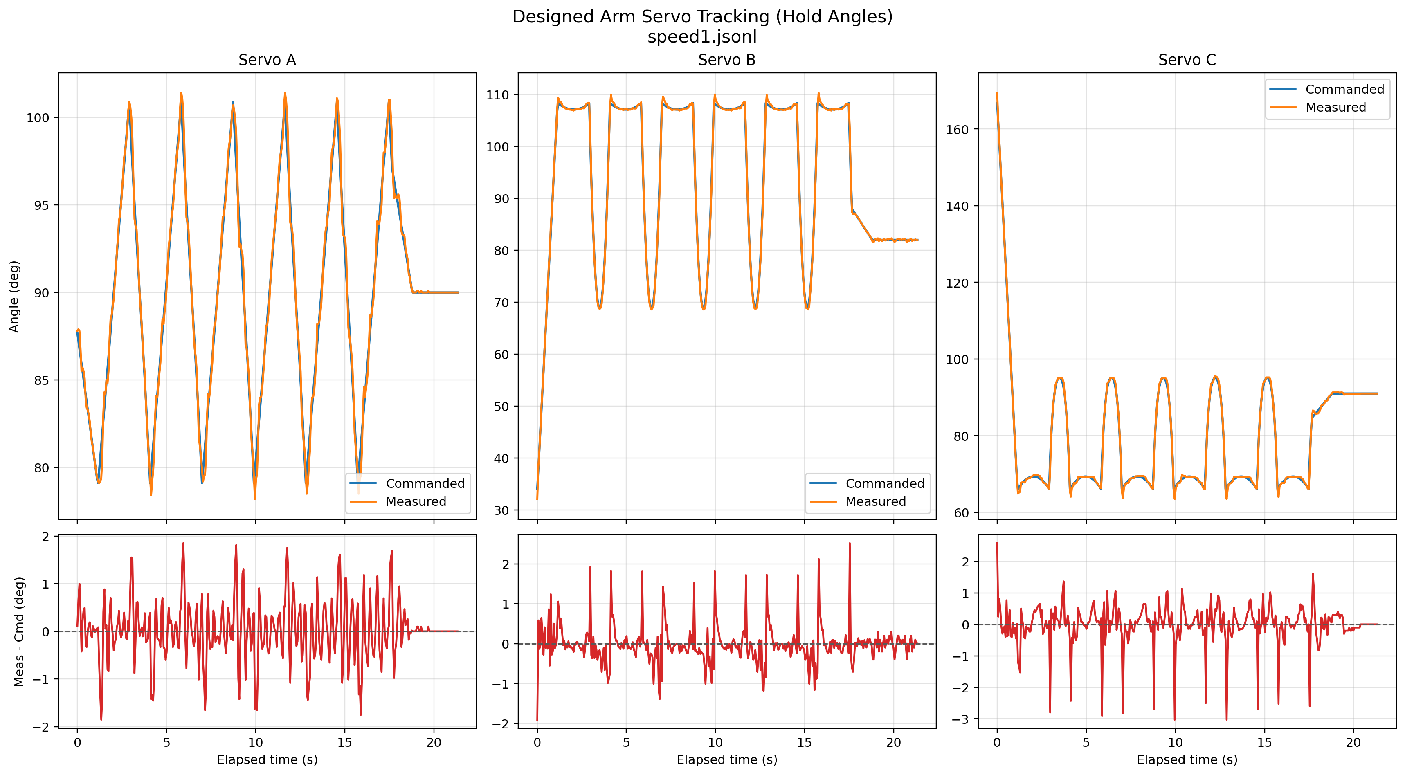
firmware/basic_control_testing/speed1_servo_tracking_relative.png
