aj-floater/hexapod/firmware/basic_control_testing/speed3_end_effector_tracking_3d.png

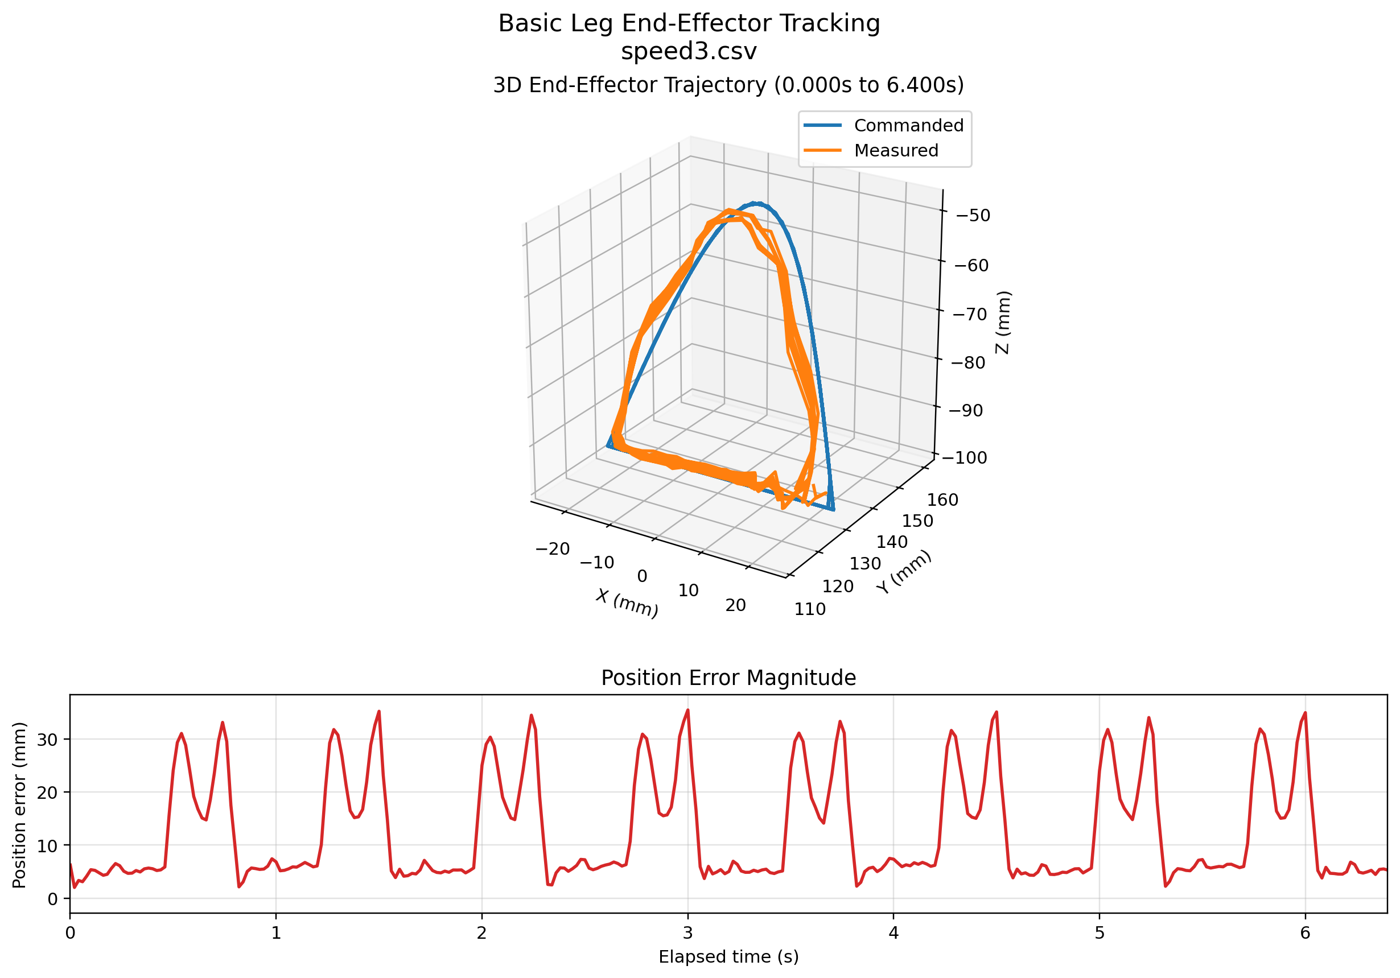
firmware/basic_control_testing/speed3_end_effector_tracking_3d.png
