aj-floater/hexapod/firmware/basic_control_testing/speed3_servo_tracking_relative.png

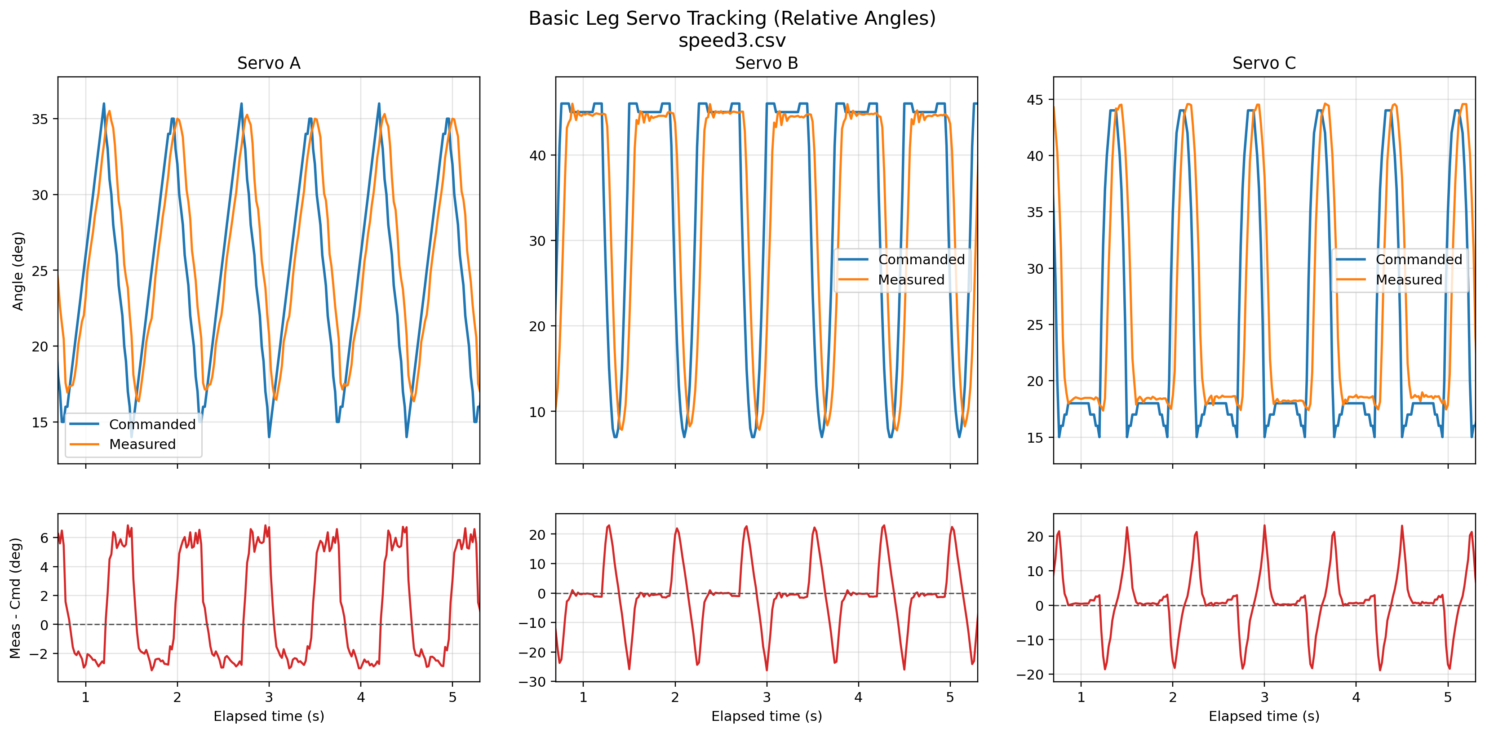
firmware/basic_control_testing/speed3_servo_tracking_relative.png
