aj-floater/hexapod/firmware/basic_control_testing/telemetry_20260430_192149_servo_tracking_relative.png

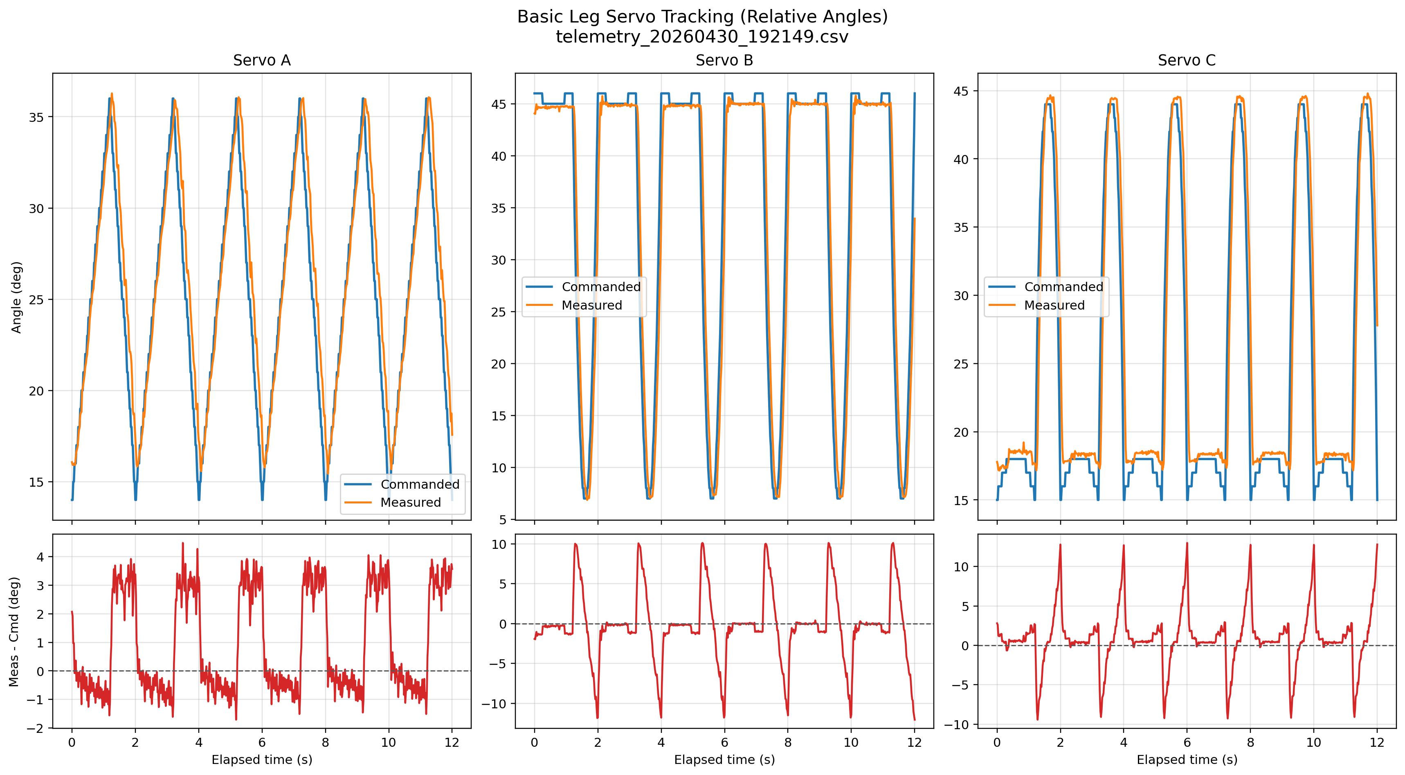
firmware/basic_control_testing/telemetry_20260430_192149_servo_tracking_relative.png
