aj-floater/hexapod/hardware/smart_servo_v2/08-12-25-smartservo-v2.pdf

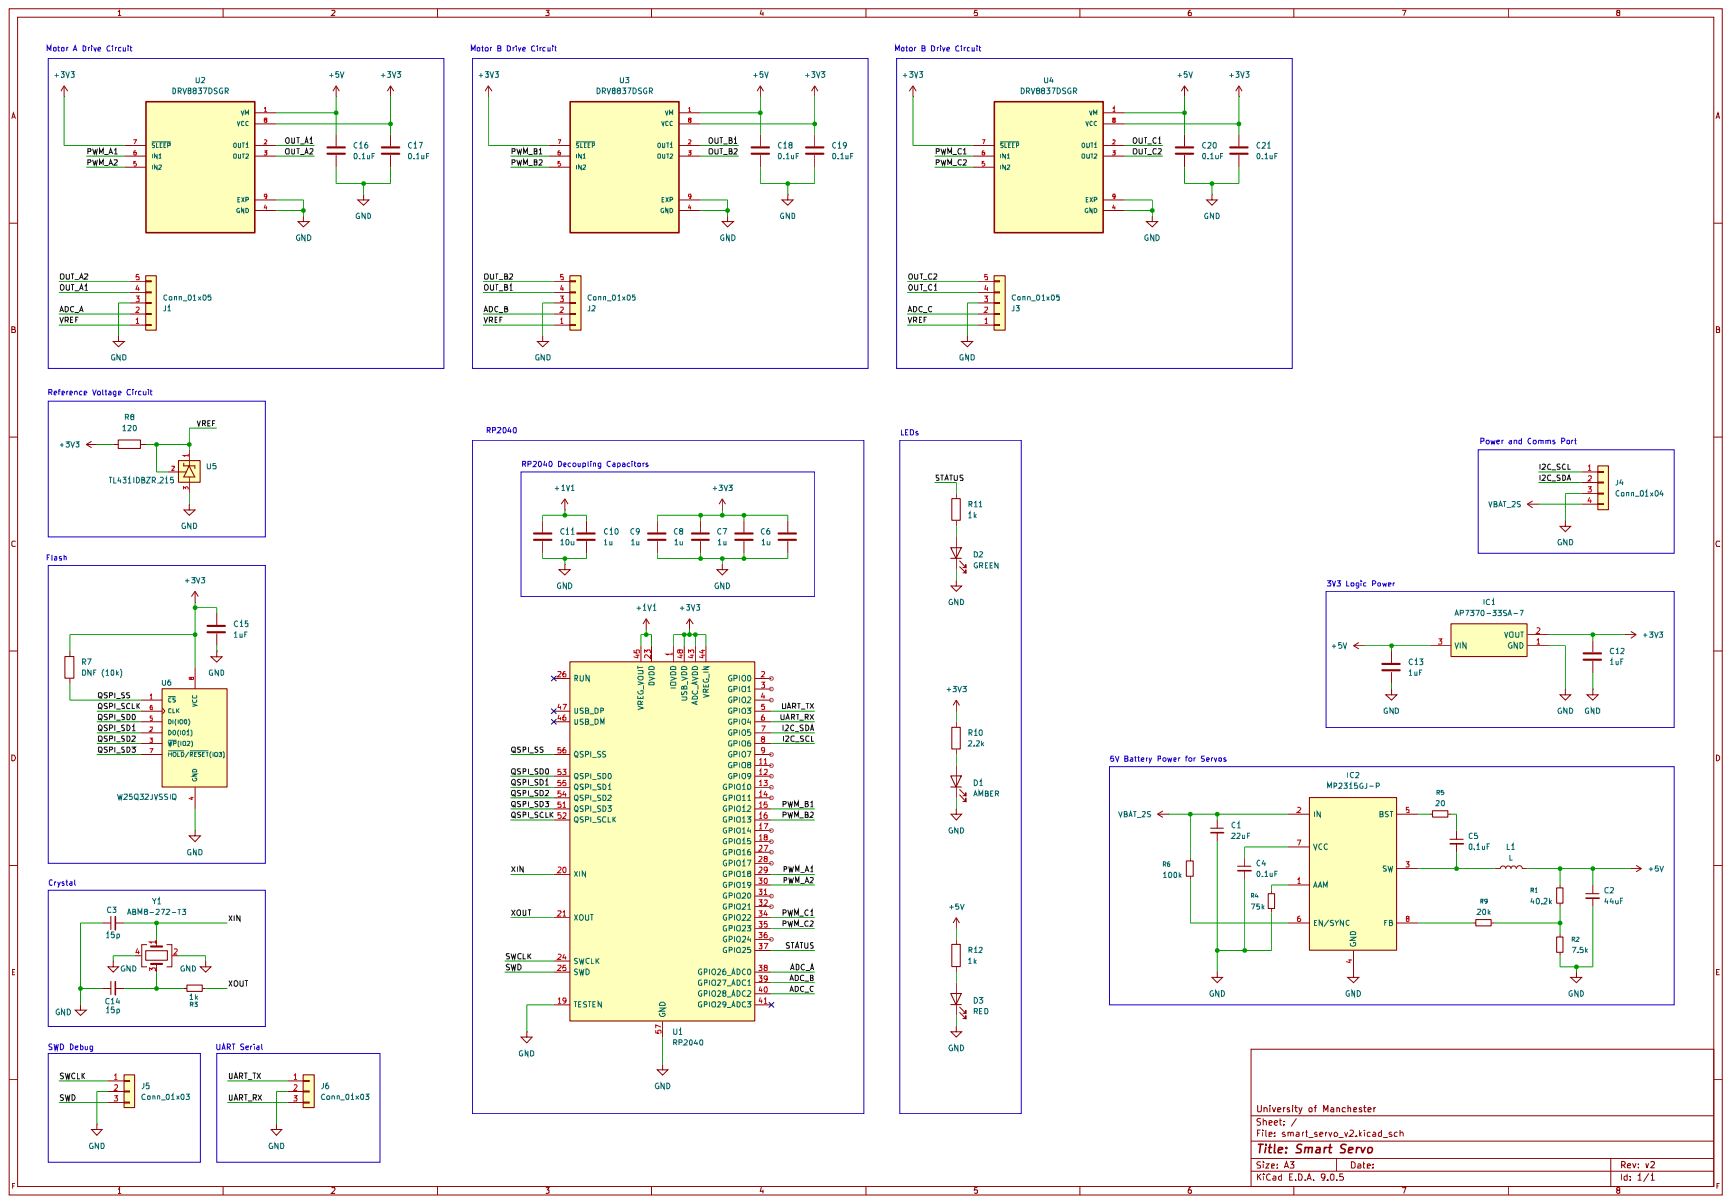
[picture p38: page 1]
