aj-floater/hexapod/firmware/common/leg_pins.h

#ifndef LEG_PINS_H
#define LEG_PINS_H

#include "pico/types.h"

#define LEG_POT_A_GPIO 26u
#define LEG_POT_B_GPIO 27u
#define LEG_POT_C_GPIO 28u

#define LEG_MOTOR_A_IN1_GPIO 18u
#define LEG_MOTOR_A_IN2_GPIO 19u
#define LEG_MOTOR_B_IN1_GPIO 13u
#define LEG_MOTOR_B_IN2_GPIO 12u
#define LEG_MOTOR_C_IN1_GPIO 22u
#define LEG_MOTOR_C_IN2_GPIO 23u

#endif
