aj-floater/hexapod/(commit log)

2025-10-16 repository for research and development of a six‑legged robot (simulation, firmware, hardware design and documentation).
2026-02-13 Add KiCad ESP32 demo project assets
    [KiCad 9 ESP32 Demo.kicad_pcb, KiCad 9 ESP32 Demo.kicad_sch, esp32-c3-02.kicad_sch]
2026-02-13 Add RP2040 minimal r2 hardware project
    [RP2040_minimal_r2-BOM.xlsx, RP2040_minimal_r2.kicad_pcb, RP2040_minimal_r2.kicad_sch]
2026-02-13 Add rc-transmitter hardware project
    [rc-transmitter.kicad_pcb, rc-transmitter.kicad_sch]
2026-02-13 Add smart_servo hardware project and artifacts
    [bom.csv, bom.xlsx, designators.csv, positions.csv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]
2026-02-13 Add smart_servo_v2 hardware project and artifacts
    [bom_v2.xlsx, first_order.csv, smart_servo_v2.kicad_pcb, smart_servo_v2.kicad_sch, smart_servo_v2.step, smart_servo_v2_bom.csv, smart_servo_v2_designators.csv, smart_servo_v2_positions.csv]
2026-02-13 Add leg firmware project with ADC serial plotter scaffold
2026-02-13 Refactor leg firmware into ADC/PWM modules and decoupled telemetry
2026-02-14 Refactor leg multicore telemetry and control split
2026-02-15 Refactor leg into telemetry sandbox loop
2026-02-15 blink_any: reduce default LED delay to 50ms
2026-02-15 leg: switch launch profile to gdb remote target
2026-02-15 blink_any_copy: fix LED default and ignore generated artifacts
2026-02-16 leg: add UART-triggered open-loop step test harness
2026-02-16 leg: add PIO UART RX on GPIO3 for command input
2026-03-12 chore: commit all changes
    [LegAssembly.FCStd, Parts.FCStd]
2026-03-28 Rename devlink tooling and share PIO UART RX
2026-03-29 Add calibrated ADC streams to control testing
2026-03-30 Add selectable low-pass ADC filtering to control testing
2026-03-30 Improve control_testing angle calibration output
2026-03-30 Add manual motor control to control_testing
2026-03-30 Commit hardware updates, session logs, and ignore .directory files
    [Callibration.FCStd, LegAssembly.FCStd, Parts.FCStd]
2026-04-06 Add position hold control mode and fix motor polarity
    Adds proportional position hold controller with tunable P gain, deadband,
    target, and max duty params. Fixes motor wiring polarity by swapping IN1/IN2
    in forward/reverse drive functions. Bumps firmware to v0.6.0.
    [control_testing.c, motor_pwm.c, position_hold.c, position_hold.h]
2026-04-08 Refactor control_testing into per-servo runtime
2026-04-08 Expand report draft and sync leg control assets
    Expand the dissertation/report material with new references, figures, and research notes. Update the leg firmware and dashboard tooling, and add the latest CAD, KiCad, and media assets for the leg controller work.
    [LegAssembly.FCStd, Parts.FCStd, leg-director.kicad_pcb, leg-director.kicad_sch]
2026-04-09 CAD Changes
    [LegAssembly.FCStd, Parts.FCStd]
2026-04-13 firmware: harden devlink serial RX and standardize on 115200
    Move the shared PIO UART RX path onto IRQ-backed ring buffers, expose dropped-byte accounting, and emit protocol.rx_overflow from firmware targets when command bytes are lost. Also remove the invalid stdio UART RX pin configuration on GP3 so the PIO receiver owns command input cleanly.
    Extend devlink telemetry support with stream ids and binary sample-format metadata in capabilities, emit binary sample frames from firmware, and teach the dashboard transport/parser stack to handle buffered serial framing and binary samples. Add the CLI diagnostic command, improve GUI command fairness under inbound traffic, and default the dashboard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
2026-05-02 Convert simulation camera to turntable
2026-05-02 Sync non-doc firmware, hardware, simulation, and tooling updates
    [LegAssembly.FCStd, Parts.FCStd, baseJoint.3mf, baseJoint.obj, baseJoint.stl, body.stl, cow.obj, cylinder.obj]
